samuelbachmann/eenvliegendsucces/docs/Images/20240127_143700.jpg

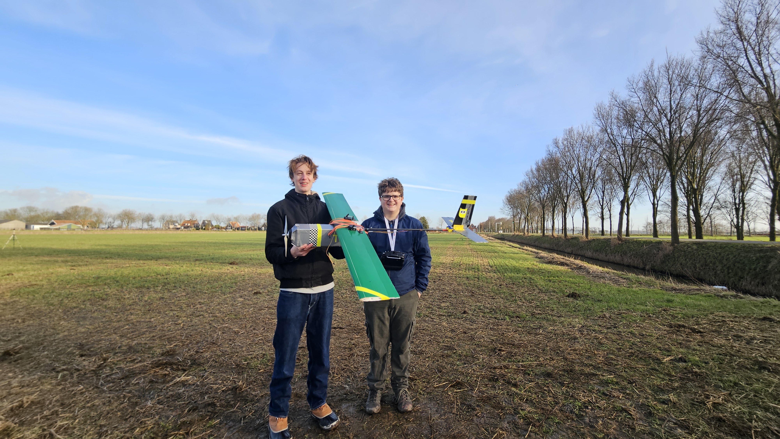
docs/Images/20240127_143700.jpg
