samuelbachmann/eenvliegendsucces/docs/Downloads/ElectronicsSupport.stl

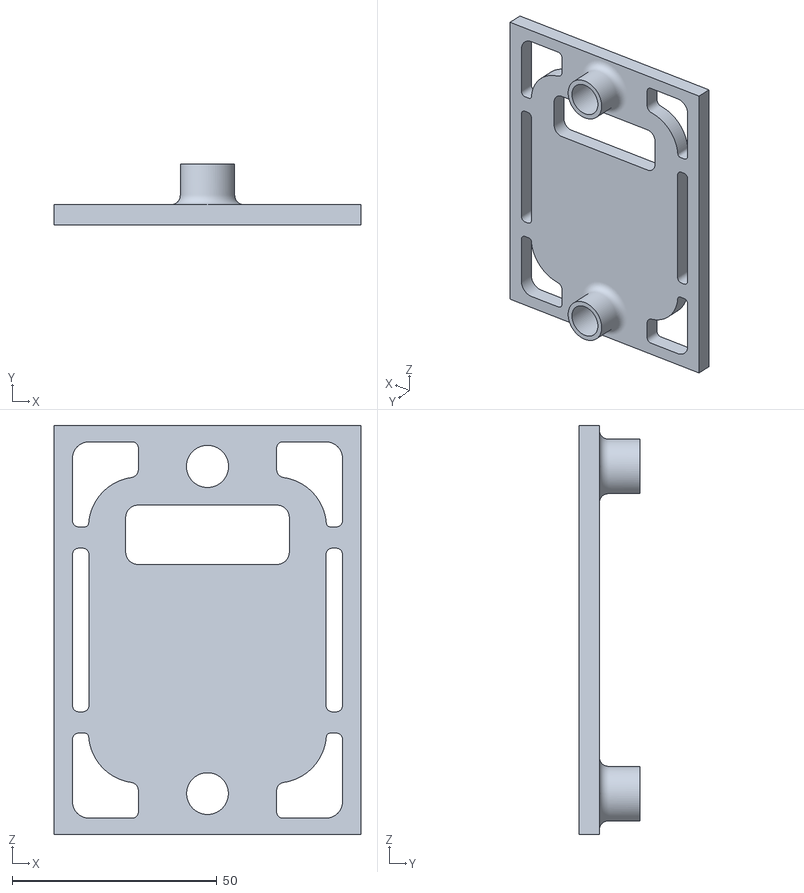
[picture p67: CAD file, 2024-01-30]
docs/Downloads/ElectronicsSupport.stl
75.0 x 15.0 x 100.0
