samuelbachmann/eenvliegendsucces/docs/Downloads/FlightControllerTubeMount.stl

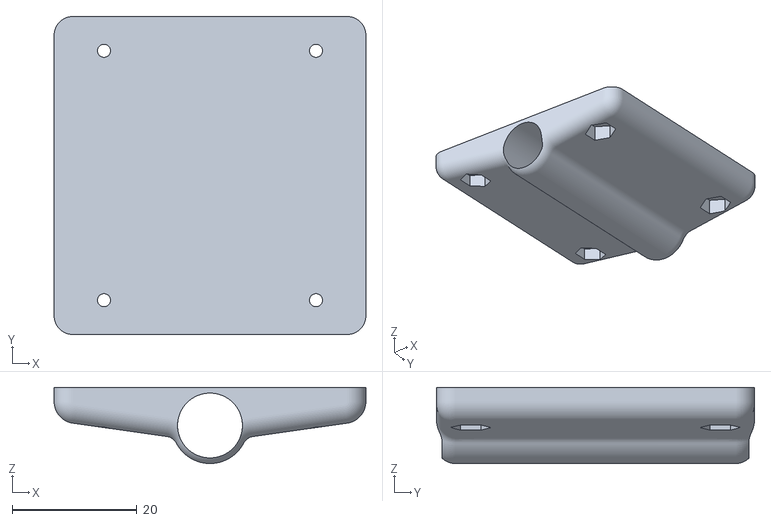
[picture p68: CAD file, 2024-01-30]
docs/Downloads/FlightControllerTubeMount.stl
50.0 x 51.0 x 12.2
