samuelbachmann/eenvliegendsucces/docs/Downloads/FlightControllerHolder.stl

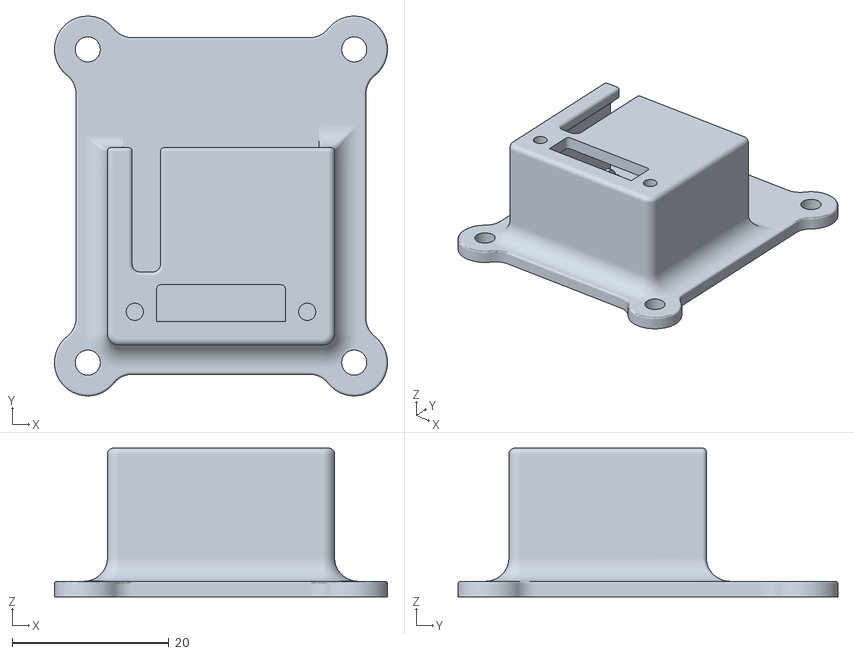
[picture p69: CAD file, 2024-01-30]
docs/Downloads/FlightControllerHolder.stl
42.5 x 48.5 x 19.0
