samuelbachmann/eenvliegendsucces/docs/Downloads/StabilizerServoMount.stl

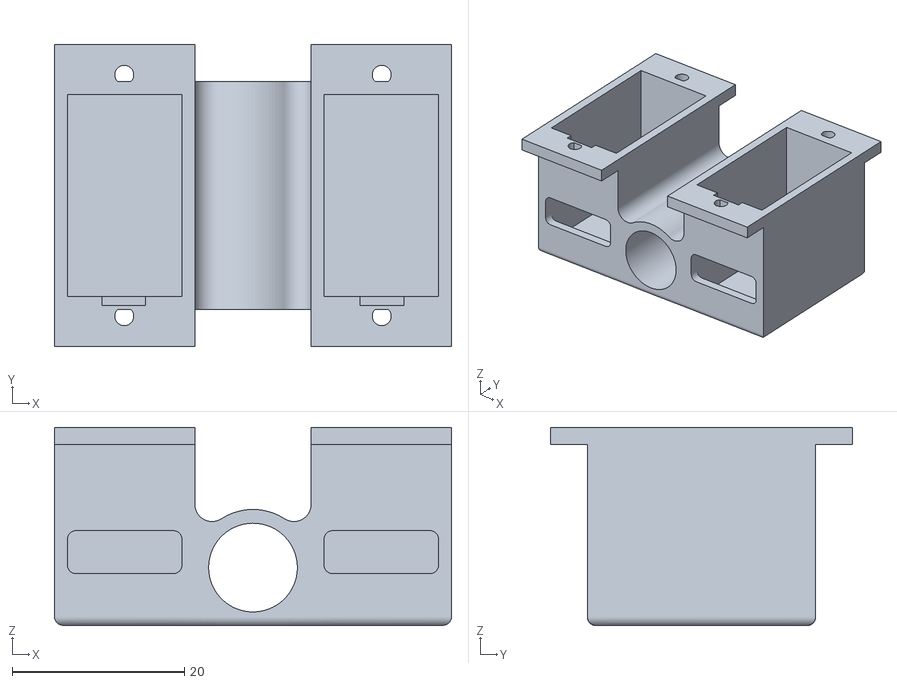
[picture p70: CAD file, 2024-01-30]
docs/Downloads/StabilizerServoMount.stl
46.1 x 35.0 x 23.0
