samuelbachmann/eenvliegendsucces/docs/Downloads/ElevatorTubeSupportMount.stl

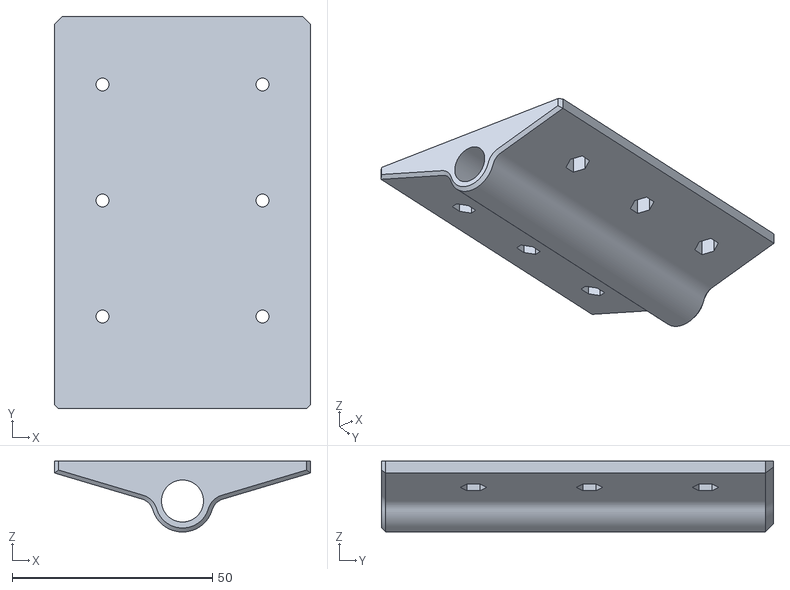
[picture p71: CAD file, 2024-01-30]
docs/Downloads/ElevatorTubeSupportMount.stl
64.0 x 98.0 x 17.7
