samuelbachmann/eenvliegendsucces/docs/Downloads/WingConnectionTubeMount2x.stl

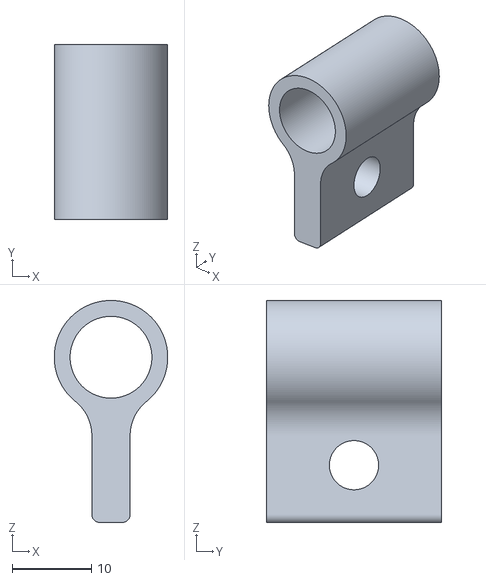
[picture p72: CAD file, 2024-01-30]
docs/Downloads/WingConnectionTubeMount2x.stl
14.3 x 22.0 x 28.0
