samuelbachmann/eenvliegendsucces/docs/Downloads/Nose.stl

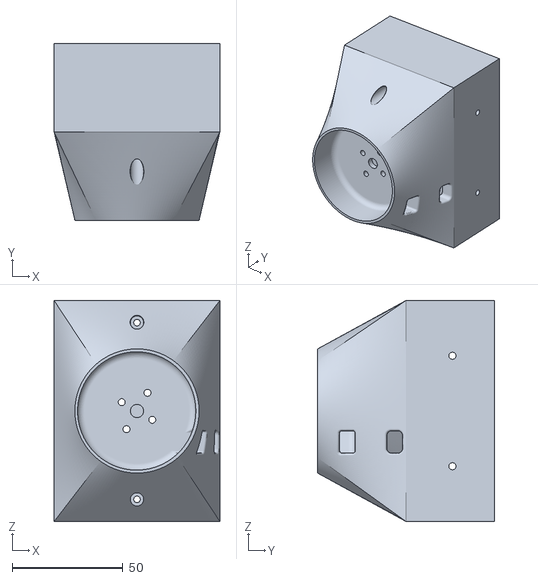
[picture p73: CAD file, 2024-01-30]
docs/Downloads/Nose.stl
75.0 x 80.0 x 100.0
