samuelbachmann/eenvliegendsucces/docs/Downloads/RudderSupport2x.stl

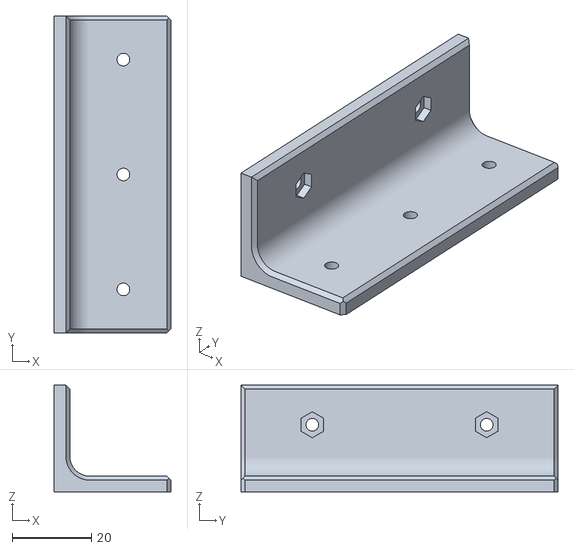
[picture p74: CAD file, 2024-01-30]
docs/Downloads/RudderSupport2x.stl
29.5 x 80.0 x 27.0
