samuelbachmann/eenvliegendsucces/docs/Downloads/SidePlateFoamTubeMontage.stl

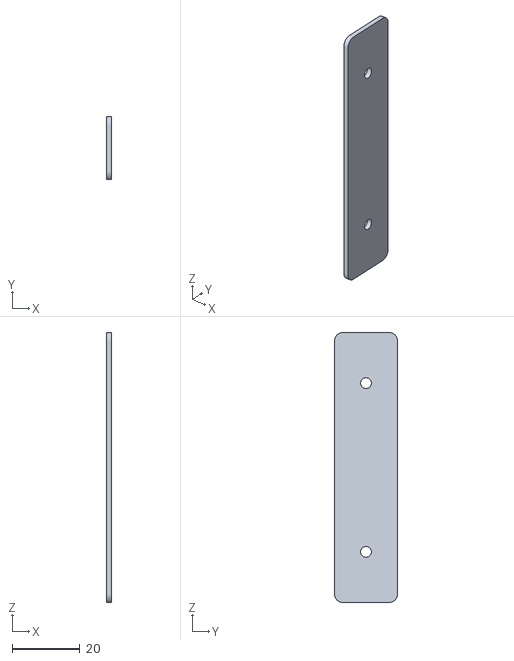
[picture p75: CAD file, 2024-01-30]
docs/Downloads/SidePlateFoamTubeMontage.stl
1.50 x 18.7 x 80.0
