samuelbachmann/eenvliegendsucces/docs/colour.pdf

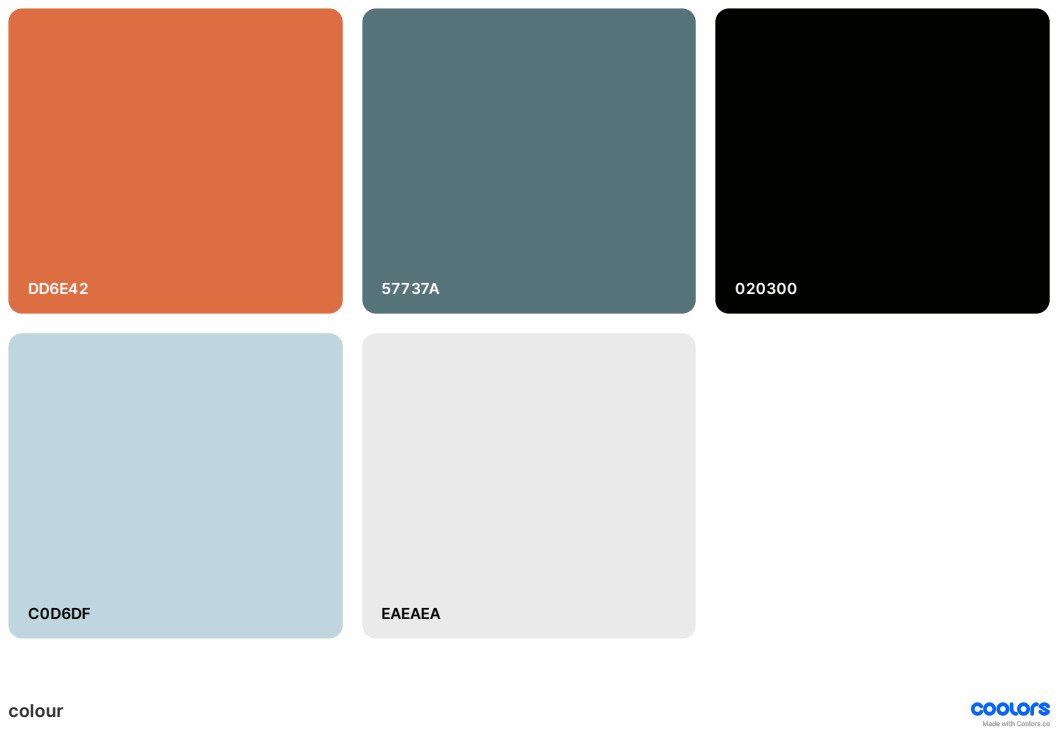
[picture p76: page 1]
EAEAEA; colour
